Hagrou/AlarmController/doc/alarmControllerFinal.png

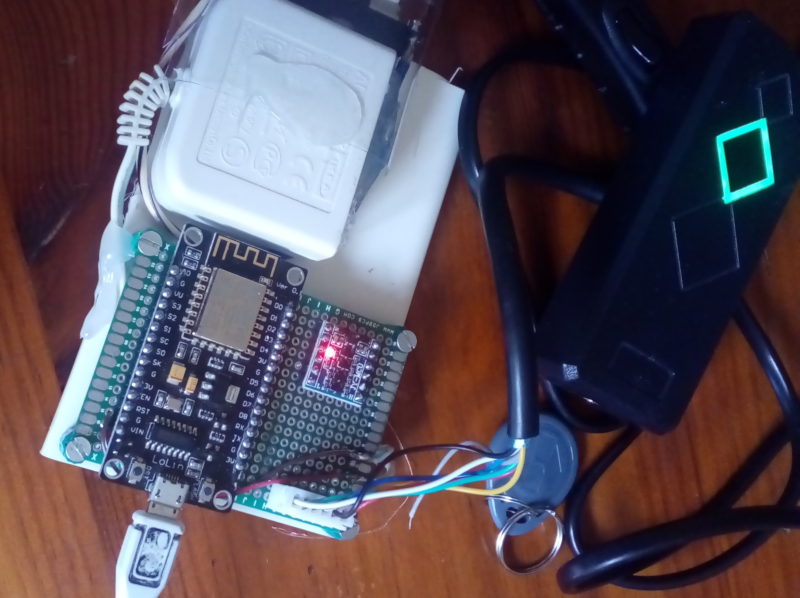
doc/alarmControllerFinal.png
