Hagrou/AlarmController/doc/IMG_20190512_090633.jpg

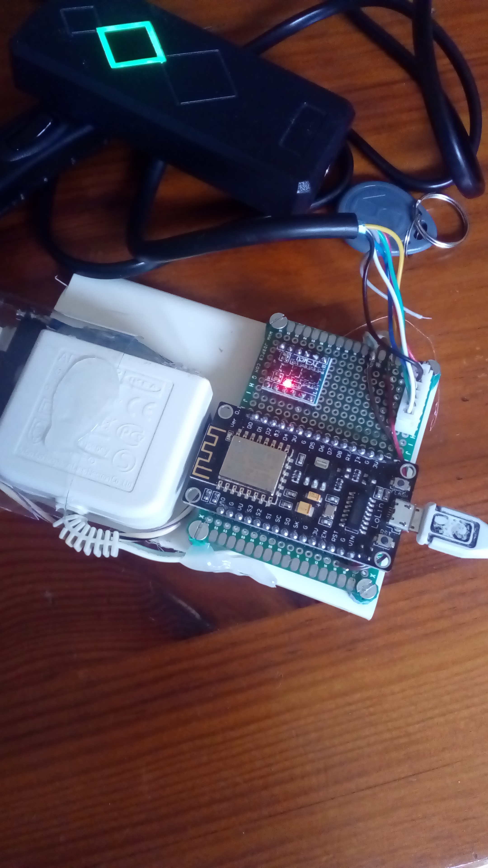
doc/IMG_20190512_090633.jpg
