Hagrou/AlarmController/doc/domoCreateMotionDevice2.png

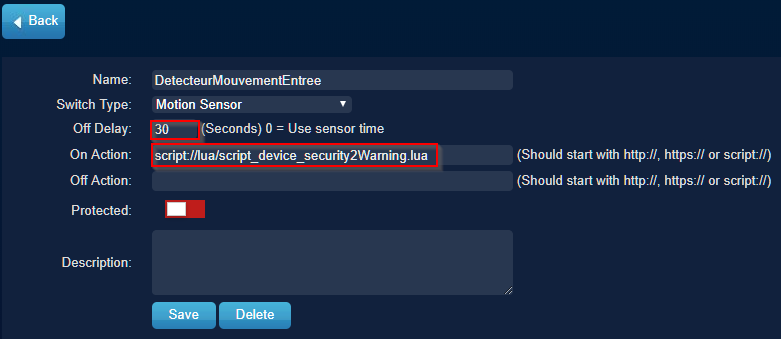
doc/domoCreateMotionDevice2.png
