Hagrou/AlarmController/doc/stateMachine2.png

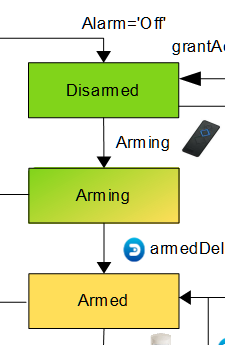
doc/stateMachine2.png
