Hagrou/AlarmController/doc/stateMachine3.png

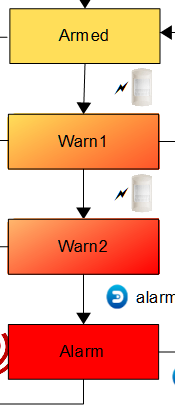
doc/stateMachine3.png
