Hagrou/AlarmController/doc/stateMachine4.png

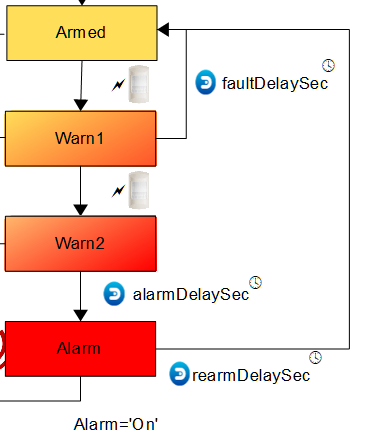
doc/stateMachine4.png
