Hagrou/AlarmController/(list of files, drawings)

Other design files:
doc/AlarmController.fzz
