Hagrou/AlarmController/(commit log)

2019-06-25 + Doc
    [AlarmController.fzz]
2020-05-20 Fix "ISR not in IRAM pb" for esp8266 board > v2.5.0
    [Wiegand.cpp]
2020-05-20 Fix "arduino.h" not found
    [Buzzer.cpp]
